ChriD/konnekting-Konnektduino/info.txt

http://www.onsemi.com/pub/Collateral/NCN5120-D.PDF

https://www.mouser.at/Semiconductors/Discrete-Semiconductors/Diodes-Rectifiers/Schottky-Diodes-Rectifiers/_/N-ax1mj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

---------------------

https://github.com/KONNEKTING/KonnektingHardware/blob/master/MicroBCU/R1.2/Schematic_1.2.pdf

-----------------------

https://forum.arduino.cc/index.php?topic=416004.0

https://github.com/AtmelUniversityFrance/atmel-samd21-xpro-boardmanagermodule

https://forum.arduino.cc/index.php?topic=409715.15

samd21j18a		4€

F303RE			6,11€
STM32F030R8		6,13€
STM32L476RG		9,60€
STM32L476RE		6,77
