ChriD/konnekting-Konnektduino/eagle/Konnektduino.core.Rev.1.0.brd

## EAGLE design eagle/Konnektduino.core.Rev.1.0.brd (2018-09-09)

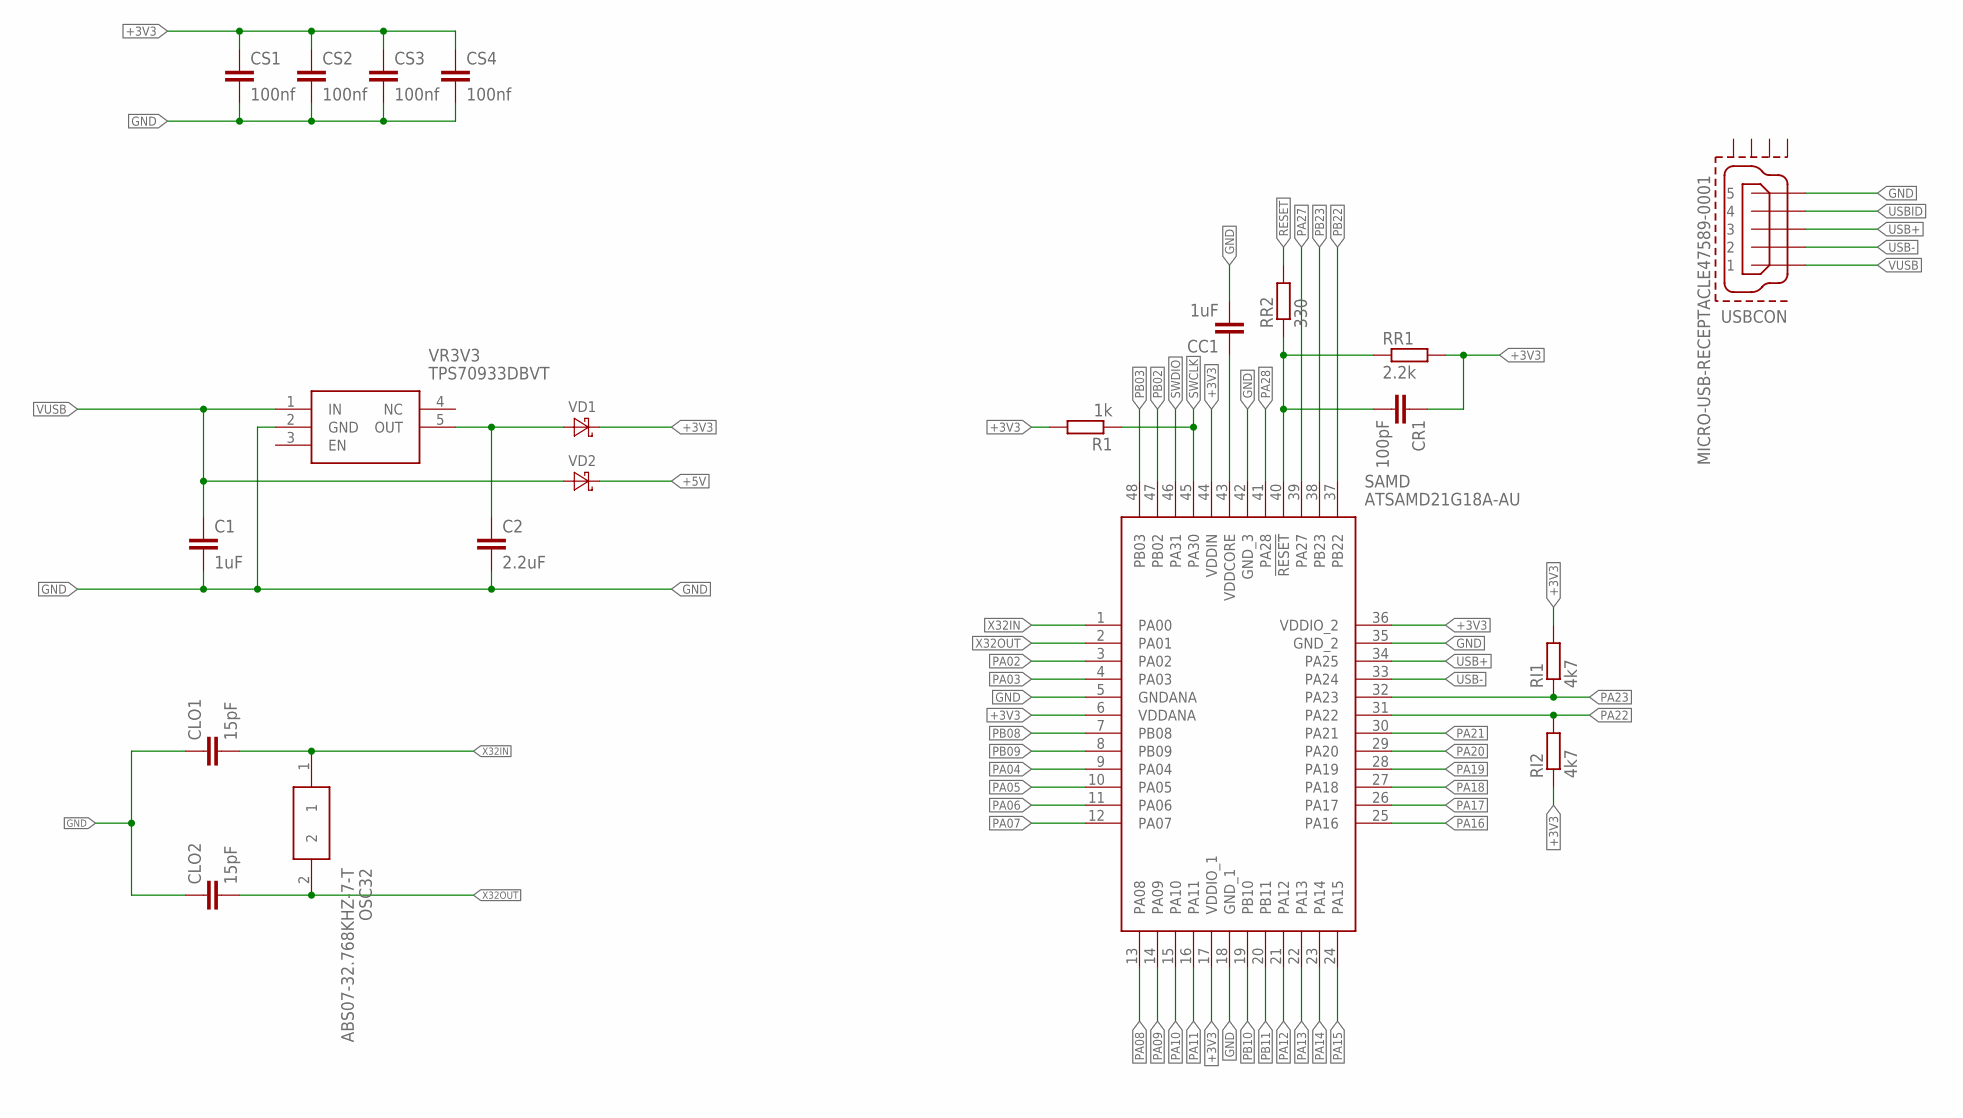
[picture p1: schematic Konnektduino.core.Rev.1.0.sch]

Parts:
C1: 1uF; C0603
C2: 2.2uF; C0603
CC1: 1uF; C0603
CLO1, CLO2: 15pF; C0603
CR1: 100pF; C0603
CS1, CS2, CS3, CS4: 100nf; C0603
OSC32: ABS07-32.768KHZ-7-T; ABS-07
R1: 1k; R0603
RI1, RI2: 4k7; R0603
RR1: 2.2k; R0603
RR2: 330; R0603
SAMD: ATSAMD21G18A-AU; QFP50P900X900X120-48N
USBCON: MICRO-USB-RECEPTACLE47589-0001; 47589-0001
VD1, VD2: DIODE-SCHOTTKY-0603; D0603
VR3V3: TPS70933DBVT; SOT95P280X145-5N

Connections:
+3V3: CR1.1, CS1.1, CS2.1, CS3.1, CS4.1, R1.2, RI1.2, RI2.1, RR1.2, SAMD.6 (VDDANA), SAMD.17 (VDDIO_1), SAMD.36 (VDDIO_2), SAMD.44 (VDDIN), VD1.C
+5V: VD2.C
GND: C1.2, C2.2, CC1.2, CLO1.1, CLO2.1, CS1.2, CS2.2, CS3.2, CS4.2, SAMD.5 (GNDANA), SAMD.18 (GND_1), SAMD.35 (GND_2), SAMD.42 (GND_3), USBCON.5, VR3V3.2 (GND)
unnamed: C2.1, VD1.A, VR3V3.5 (OUT)
NRST: CR1.2, RR1.1, RR2.1, SAMD.40 (!RESET)
PA02: SAMD.3 (PA02)
PA03: SAMD.4 (PA03)
PA04: SAMD.9 (PA04)
PA05: SAMD.10 (PA05)
PA06: SAMD.11 (PA06)
PA07: SAMD.12 (PA07)
PA08: SAMD.13 (PA08)
PA09: SAMD.14 (PA09)
PA10: SAMD.15 (PA10)
PA11: SAMD.16 (PA11)
PA12: SAMD.21 (PA12)
PA13: SAMD.22 (PA13)
PA14: SAMD.23 (PA14)
PA15: SAMD.24 (PA15)
PA16: SAMD.25 (PA16)
PA17: SAMD.26 (PA17)
PA18: SAMD.27 (PA18)
PA19: SAMD.28 (PA19)
PA20: SAMD.29 (PA20)
PA21: SAMD.30 (PA21)
PA22: RI2.2, SAMD.31 (PA22)
PA23: RI1.1, SAMD.32 (PA23)
PA27: SAMD.39 (PA27)
PA28: SAMD.41 (PA28)
PB02: SAMD.47 (PB02)
PB03: SAMD.48 (PB03)
PB08: SAMD.7 (PB08)
PB09: SAMD.8 (PB09)
PB10: SAMD.19 (PB10)
PB11: SAMD.20 (PB11)
PB22: SAMD.37 (PB22)
PB23: SAMD.38 (PB23)
RESET: RR2.2
SWCLK: R1.1, SAMD.45 (PA30)
SWDIO: SAMD.46 (PA31)
USB+: SAMD.34 (PA25), USBCON.3
USB-: SAMD.33 (PA24), USBCON.2
USBID: USBCON.4
VDDCORE: CC1.1, SAMD.43 (VDDCORE)
VUSB: C1.1, USBCON.1, VD2.A, VR3V3.1 (IN)
X32IN: CLO1.2, OSC32.1, SAMD.1 (PA00)
X32OUT: CLO2.2, OSC32.2, SAMD.2 (PA01)

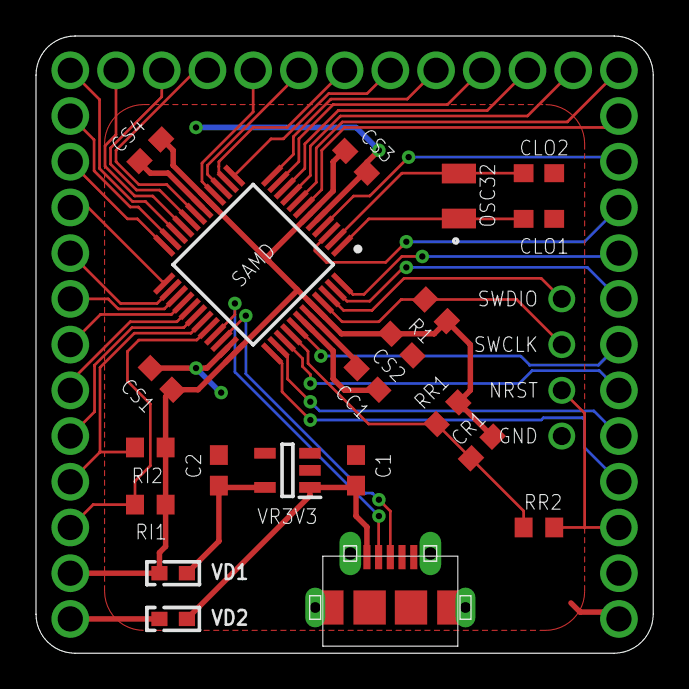
[picture p2: board Konnektduino.core.Rev.1.0.brd from above]

Board: 2 copper layers, 34.3 x 34.3 mm, 21 parts (0 on the bottom side), 13 nets.
