ChriD/konnekting-Konnektduino/eagle/Konnektduino.knx.Rev.1.0.brd

## EAGLE design eagle/Konnektduino.knx.Rev.1.0.brd (2018-09-09)

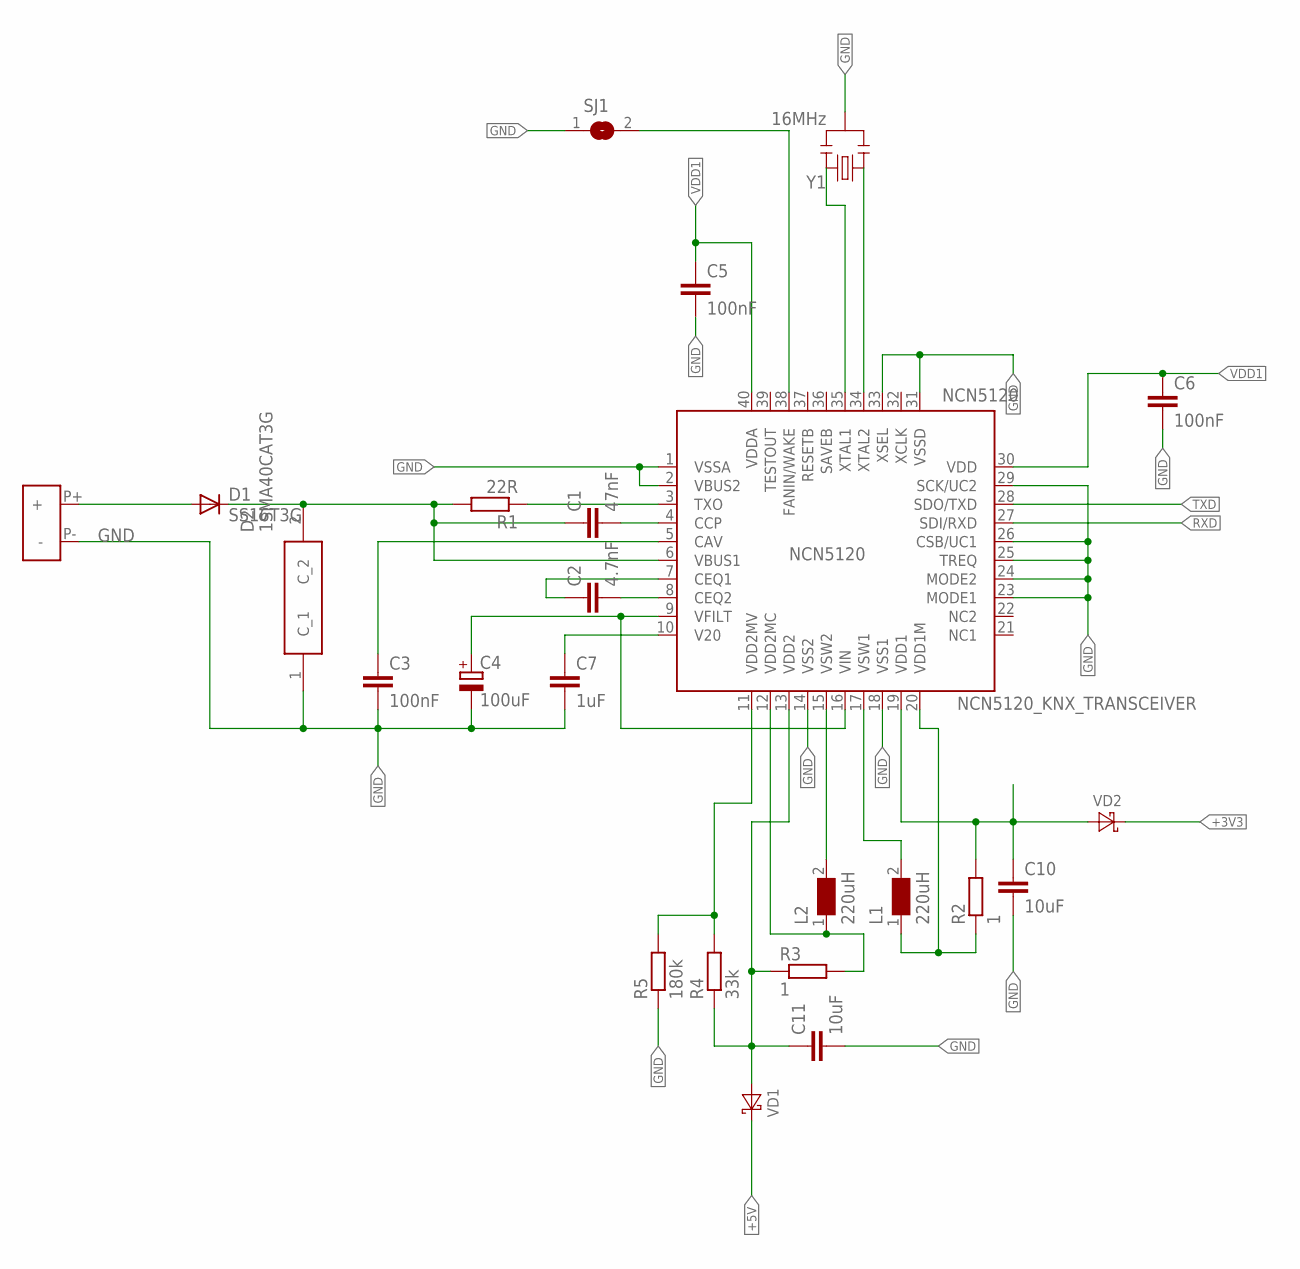
[picture p3: schematic Konnektduino.knx.Rev.1.0.sch]

Parts:
C1: 47nF; C0603
C2: 4.7nF; C0603
C3, C5, C6: 100nF; C0603
C4: 100uF; PANASONIC_E
C7: 1uF; C0603
C10, C11: 10uF; C0603
D1: SS16T3G; SMA-DIODE_ALT
D2: 1SMA40CAT3G; DIONM5226X220N
L1, L2: 220uH; WE-PD2_7850
NCN5120: NCN5120_KNX_TRANSCEIVER; QFN40
R1: 22R; R1218
R2, R3: 1; R0603
R4: 33k; R0603
R5: 180k; R0603
SJ1: SJW
U$2: KNX_KLEMME
VD1, VD2: DIODE-SCHOTTKY-0603; D0603
Y1: 16MHz; RESONATOR-SMD

Connections:
+3V3: VD2.C
+5V: VD1.C
GND: C3.2, C4.-, C5.2, C6.2, C7.2, C10.2, C11.2, D2.1 (C_1), NCN5120.1 (VSSA), NCN5120.2 (VBUS2), NCN5120.14 (VSS2), NCN5120.18 (VSS1), NCN5120.23 (MODE1), NCN5120.24 (MODE2), NCN5120.25 (TREQ), NCN5120.26 (CSB/UC1), NCN5120.29 (SCK/UC2), NCN5120.31 (VSSD), NCN5120.33 (XSEL), R5.1, SJ1.1, U$2.P- (-), Y1.2
unnamed: C1.1, D1.C, D2.2 (C_2), NCN5120.6 (VBUS1), R1.2
unnamed: C2.1, NCN5120.7 (CEQ1)
unnamed: C4.+, NCN5120.9 (VFILT), NCN5120.16 (VIN)
unnamed: L2.2, NCN5120.15 (VSW2)
unnamed: C1.2, NCN5120.4 (CCP)
unnamed: C7.1, NCN5120.10 (V20)
unnamed: NCN5120.11 (VDD2MV), R4.2, R5.2
unnamed: L2.1, NCN5120.12 (VDD2MC), R3.2
unnamed: C3.1, NCN5120.5 (CAV)
unnamed: C2.2, NCN5120.8 (CEQ2)
unnamed: NCN5120.38 (FANIN/WAKE), SJ1.2
unnamed: D1.A, U$2.P+ (+)
unnamed: L1.2, NCN5120.17 (VSW1)
unnamed: L1.1, NCN5120.20 (VDD1M), R2.1
unnamed: NCN5120.3 (TXO), R1.1
RXD: NCN5120.27 (SDI/RXD)
TXAL1: NCN5120.35 (XTAL1), Y1.3
TXAL2: NCN5120.34 (XTAL2), Y1.1
TXD: NCN5120.28 (SDO/TXD)
VDD1: C5.1, C6.1, C10.1, NCN5120.19 (VDD1), NCN5120.30 (VDD), NCN5120.40 (VDDA), R2.2, VD2.A
VDD2: C11.1, NCN5120.13 (VDD2), R3.1, R4.1, VD1.A

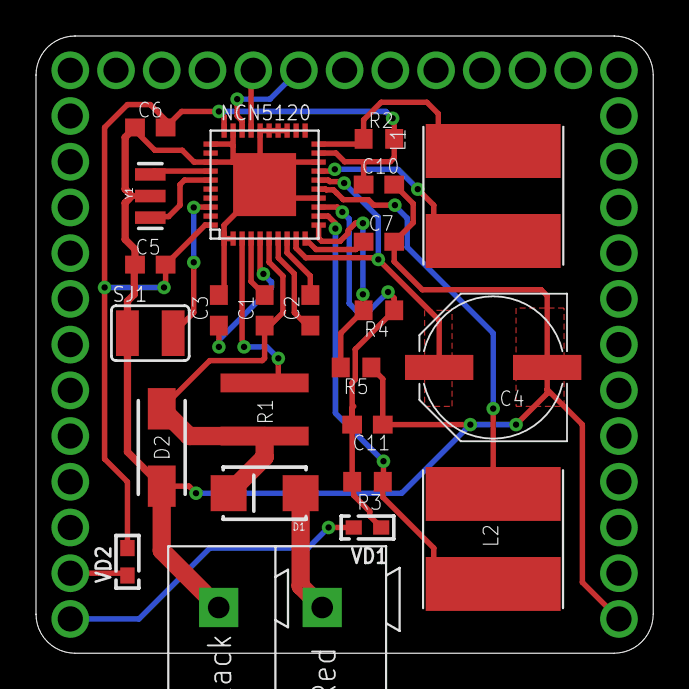
[picture p4: board Konnektduino.knx.Rev.1.0.brd from above]

Board: 2 copper layers, 34.3 x 34.3 mm, 24 parts (0 on the bottom side), 20 nets.
