ChriD/konnekting-Konnektduino/(notices)

Notices in the files:
parts and their libraries:
Wuerth_PowerMagnetics: Copyright: Würth Elektronik
con-molex-usb: (C) 2014 Tomasz Boleslaw CEDRO, cederom@tlen.pl, http://www.tomek.cedro.info.
